garnerm91/SWCAN/GMlan.pdf

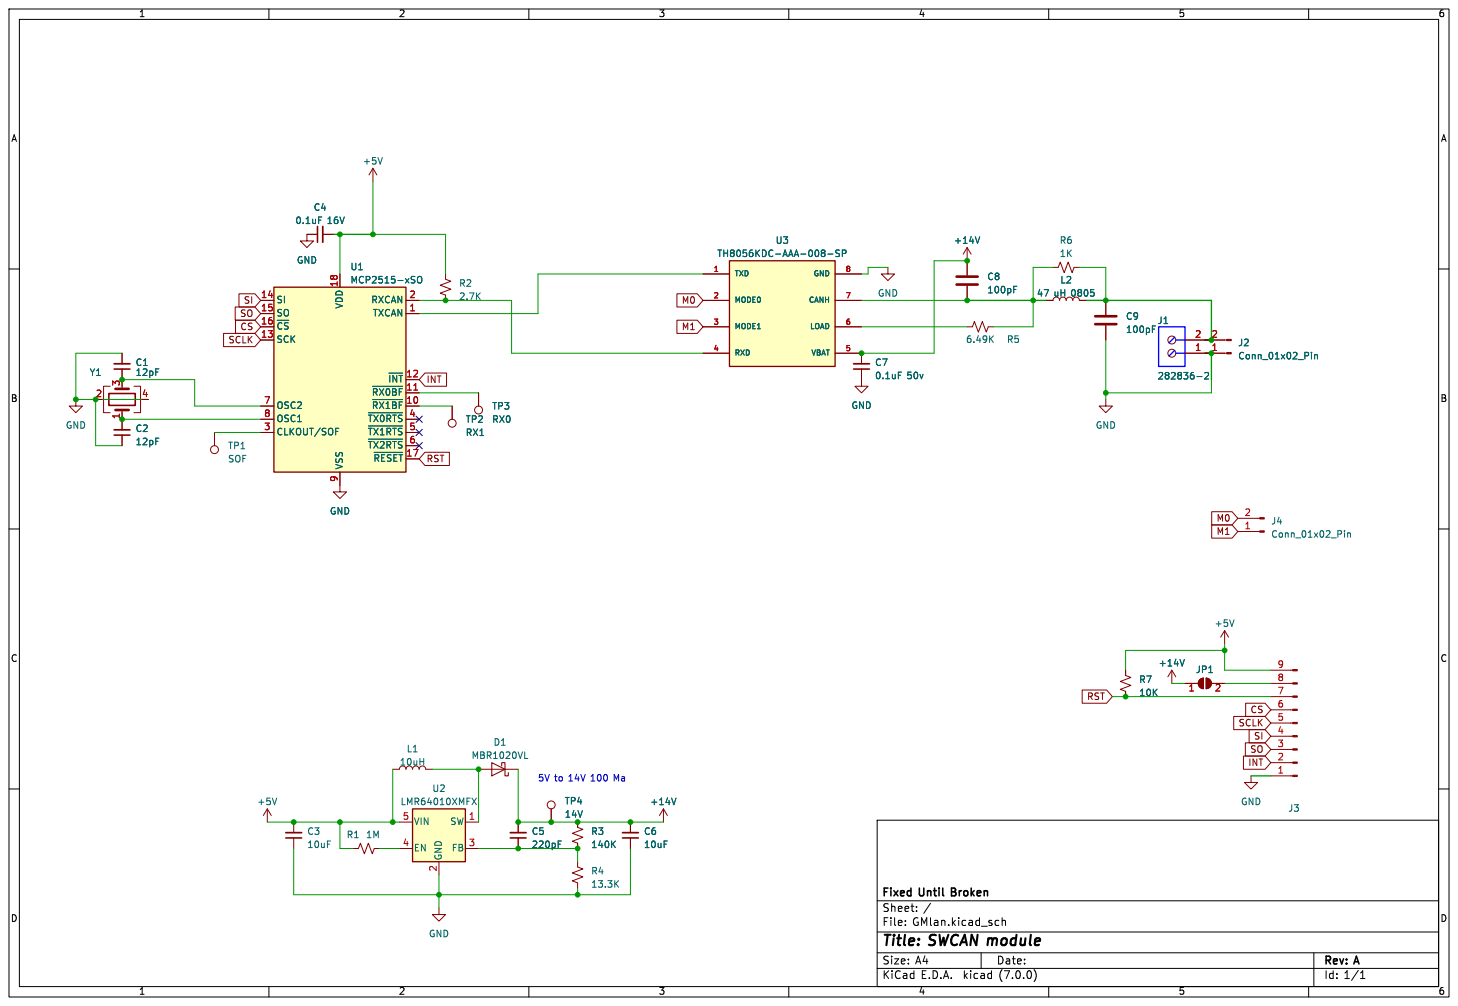
[picture p3: page 1]

Id: 1/1 Title: SWCAN module
