garnerm91/SWCAN/(commit log)

2024-07-06 Add files via upload
    Rev A Gerber
2024-07-06 Add BOM.
    [GMlan.csv]
2024-07-07 add the footprint and Symbol
